lambdamikel/Speak-SID/images/speakjet-3d.jpg

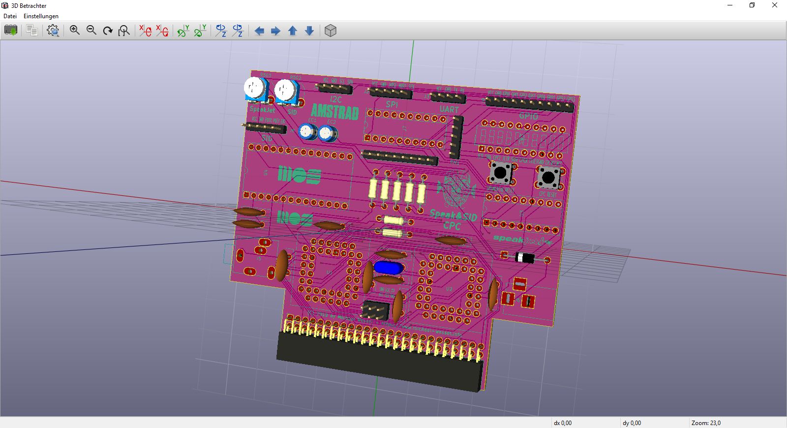
images/speakjet-3d.jpg
