lambdamikel/Speak-SID/images/speaksid-pcb-1-b.JPG

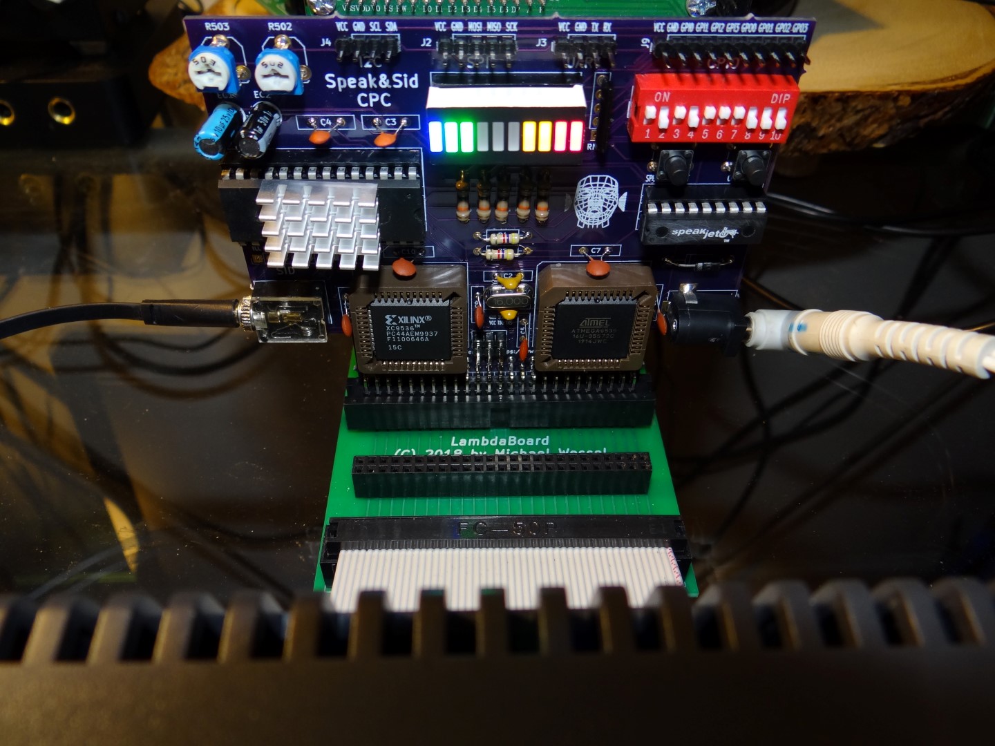
images/speaksid-pcb-1-b.JPG
