lambdamikel/Speak-SID/images/speaksid-pcb-2-b.JPG

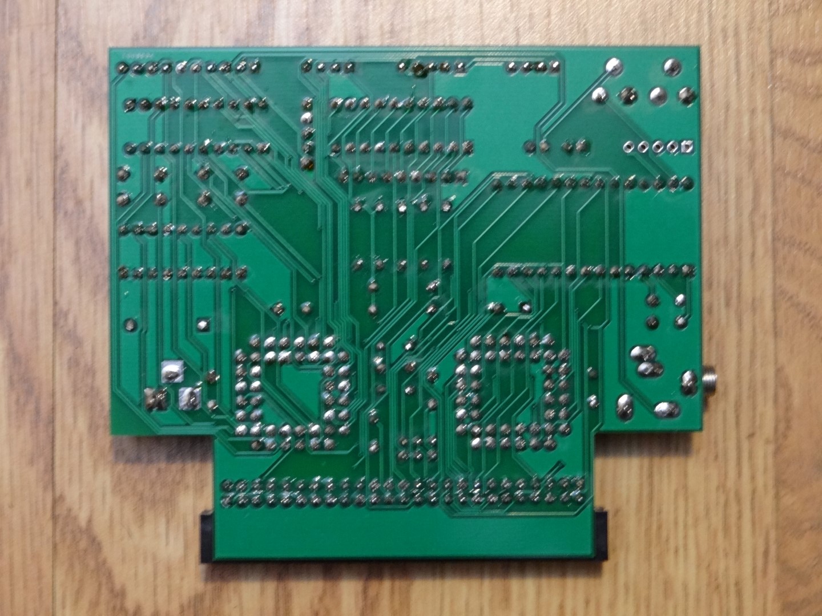
images/speaksid-pcb-2-b.JPG
