lambdamikel/Speak-SID/manuals/SID_original_schematic.png

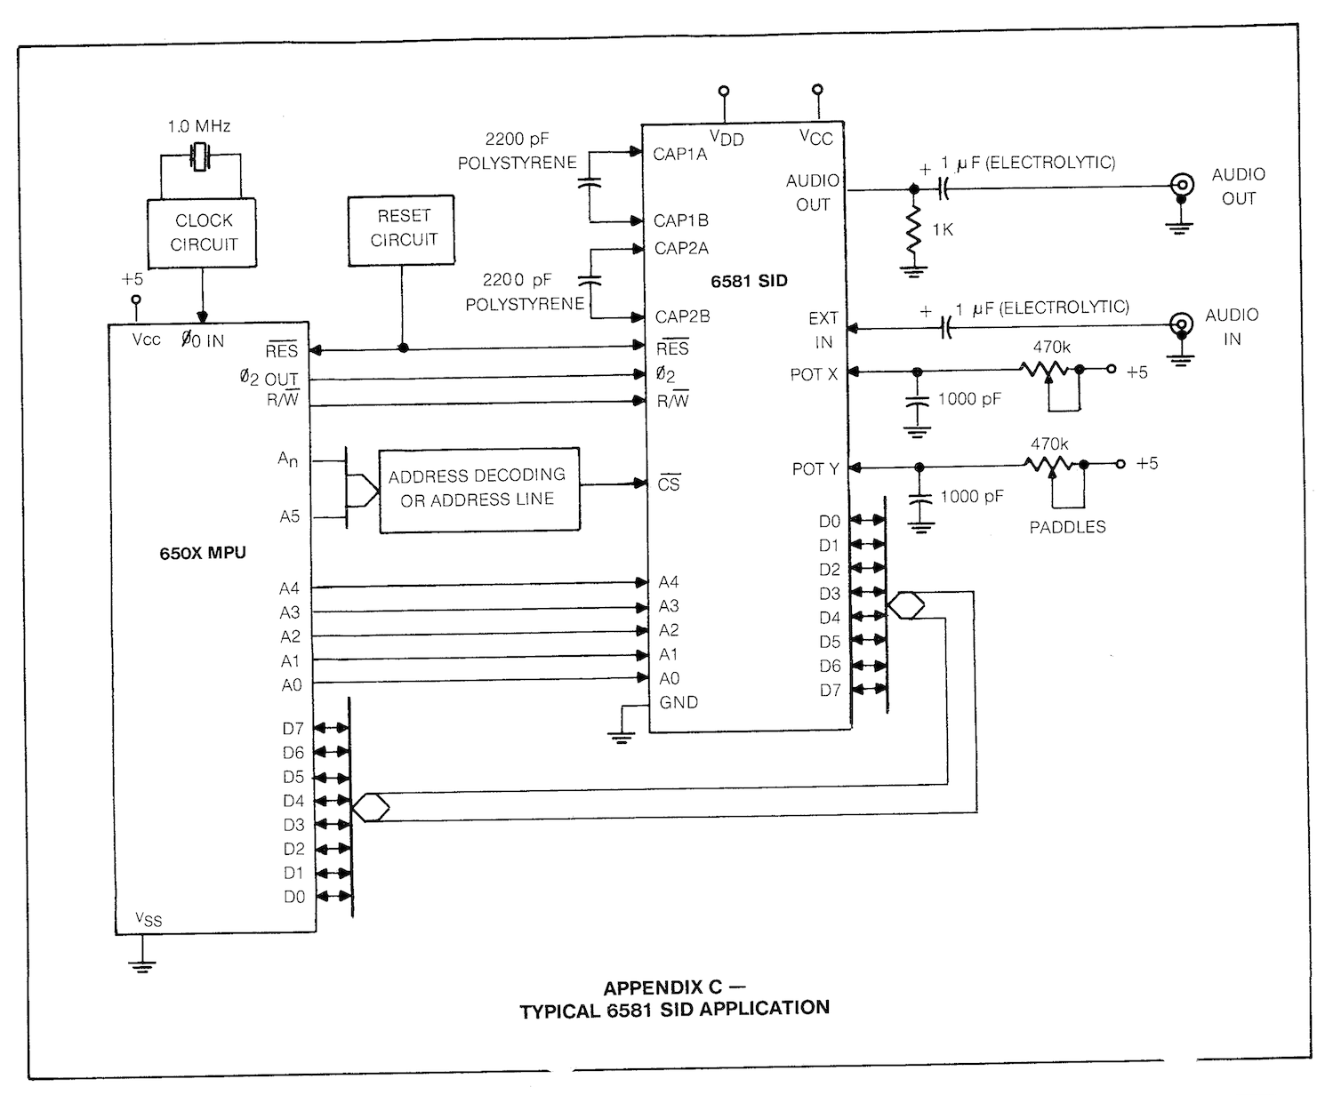
manuals/SID_original_schematic.png
