lambdamikel/Speak-SID/schematics/bom.jpg

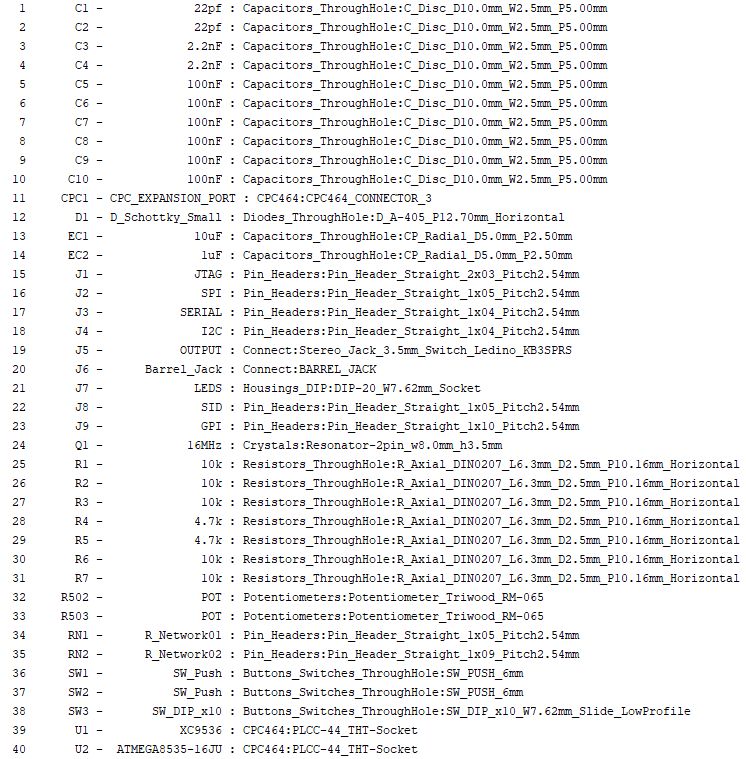
schematics/bom.jpg
