lambdamikel/Speak-SID/schematics/speakjet-bw.pdf

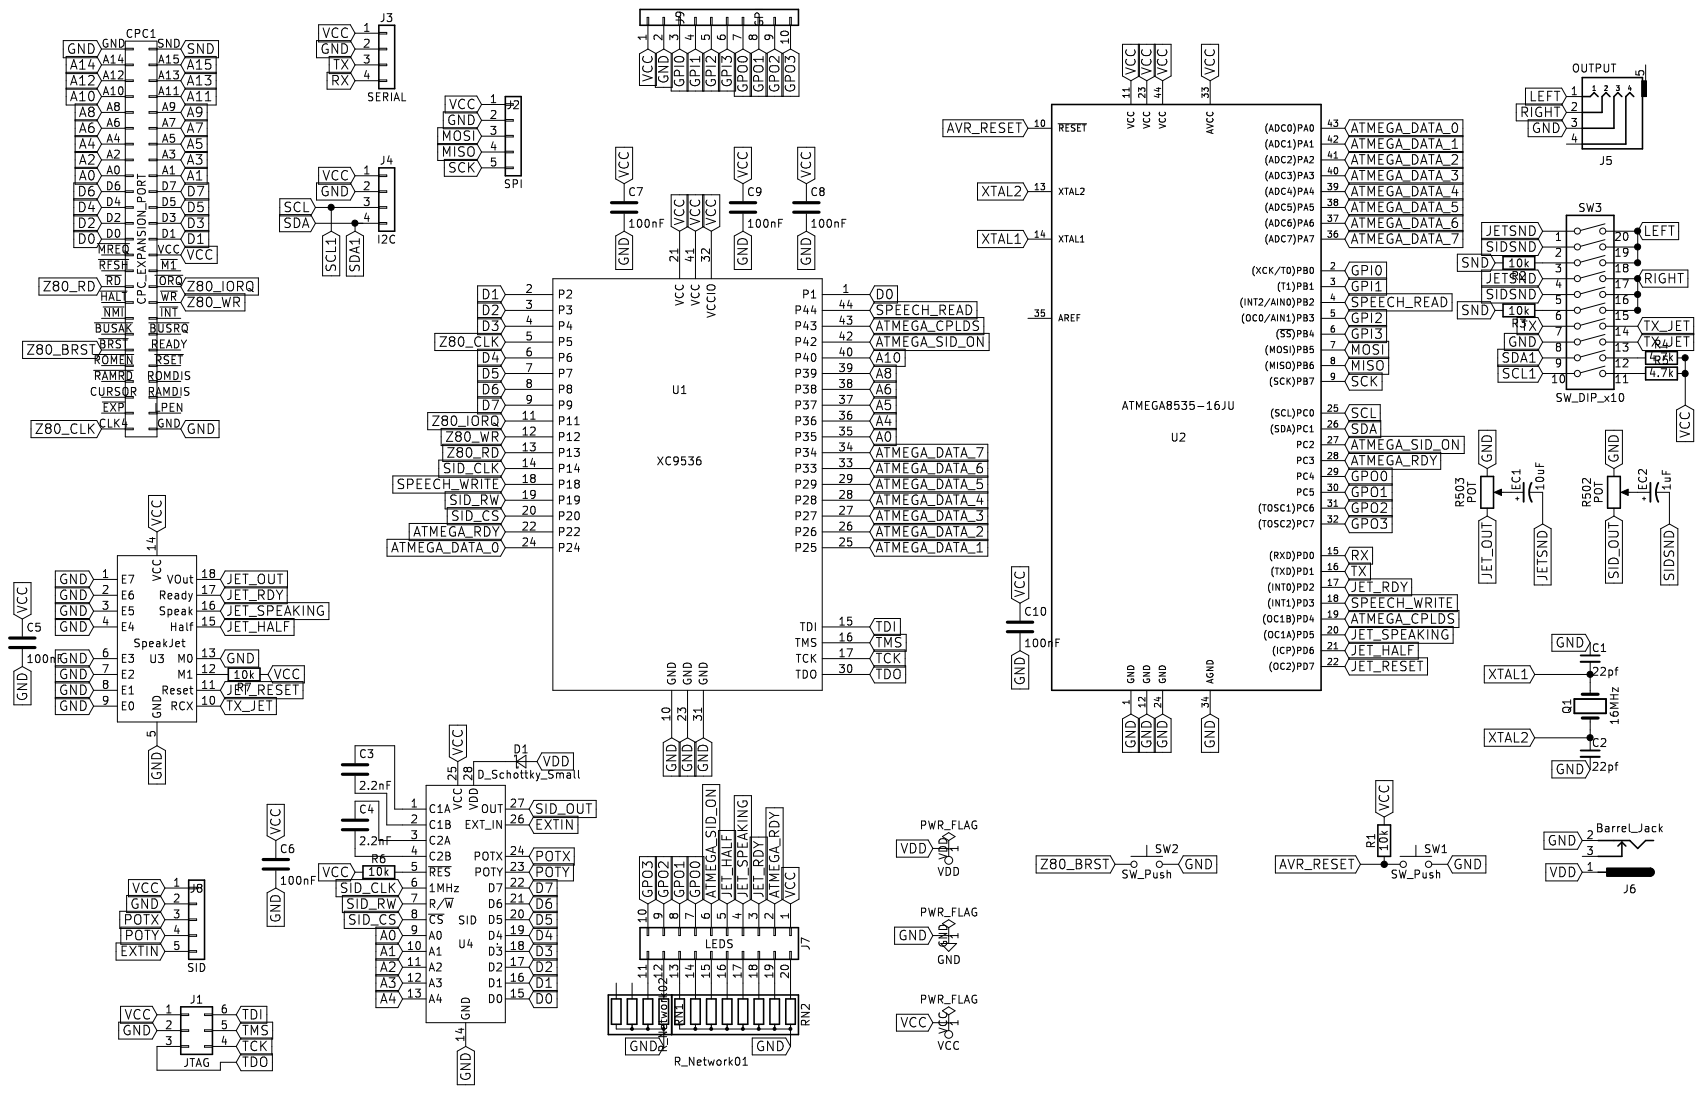
[picture p22: page 1]
