lambdamikel/Speak-SID/schematics/speaksid.pdf

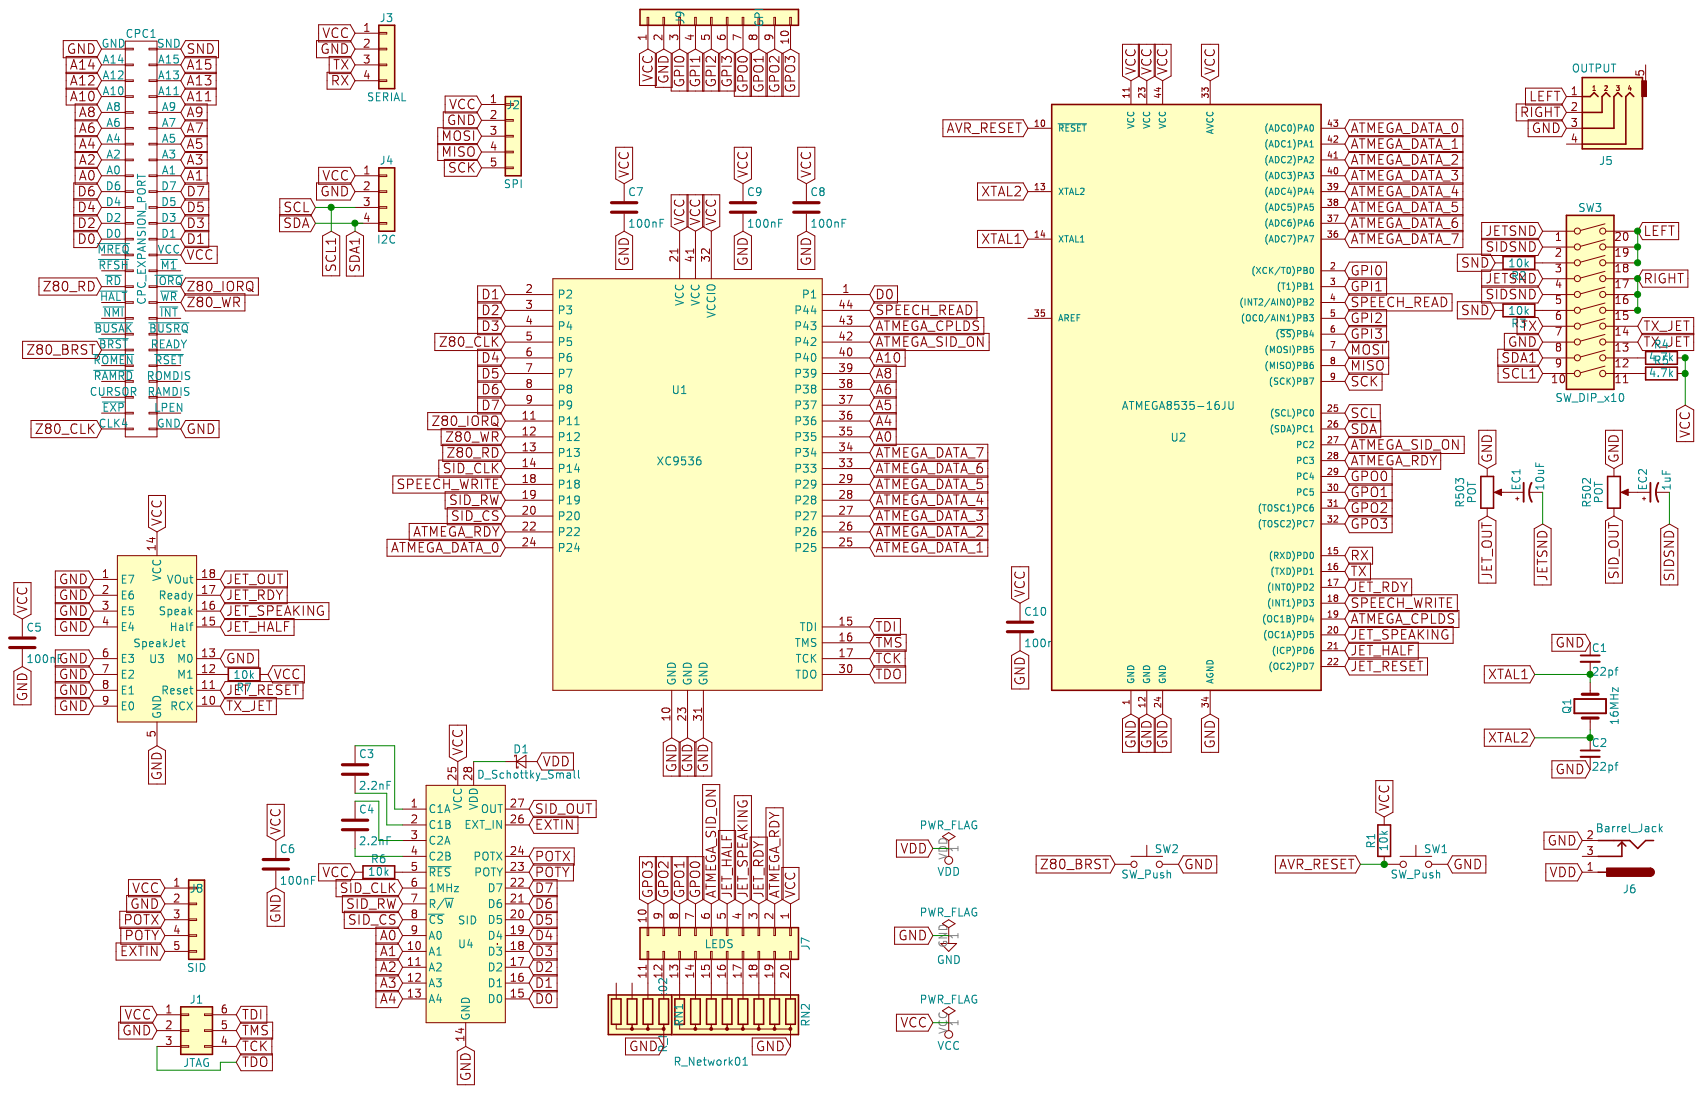
[picture p23: page 1]
