lambdamikel/Speak-SID/(commit log)

2019-11-11 SID Player update - LED light show.
2019-11-17 README.md - document LEDs.
2019-11-17 README.md document LEDs.
2019-11-17 README.md update LEDs
2019-11-17 README.md document LEDs update.
2019-11-17 README.md document DIP switch.
2019-11-17 Adding DIP switch jpeg for README.md.
2019-11-18 LED jpeg image resized.
2019-12-02 Adding pictures of PCB revision 2 (final version).
2019-12-05 Speak&SID CPC Disk Update - Now with AY+SID MIDI IN SYNTH.BAS Demo Program! Requires MAXAM Assembler.
2021-03-22 README.md update - Speak&SID On/Off Switch mod.
2023-04-20 Demo programs for USIfAC MIDI INPUT for Speak&SID. Requires a modded Speak&SID. Note that these programs are only required if you want to control the SpeakJet chip via MIDI IN; then, USIfAC is used f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
2023-04-20 Couple pictures: Speak&SID mod for USIfAC I MIDI.
