lambdamikel/Speak-SID/(notices)

Notices in the files:
src/atmega8535/speaksid/speaksid.c:
This program is free software; you can redistribute it and/or modify
it under the terms of the GNU General Public License as published by
the Free Software Foundation; either version 3 of the License, or
(at your option) any later version.
Speak&SID CPC version 2, Copyright (C) 2019 Michael Wessel
